jason-merlo/AP-S-2020-Radar-Board/aps_radar.kicad_pcb

## KiCad design aps_radar.kicad_pcb (2020-03-13)

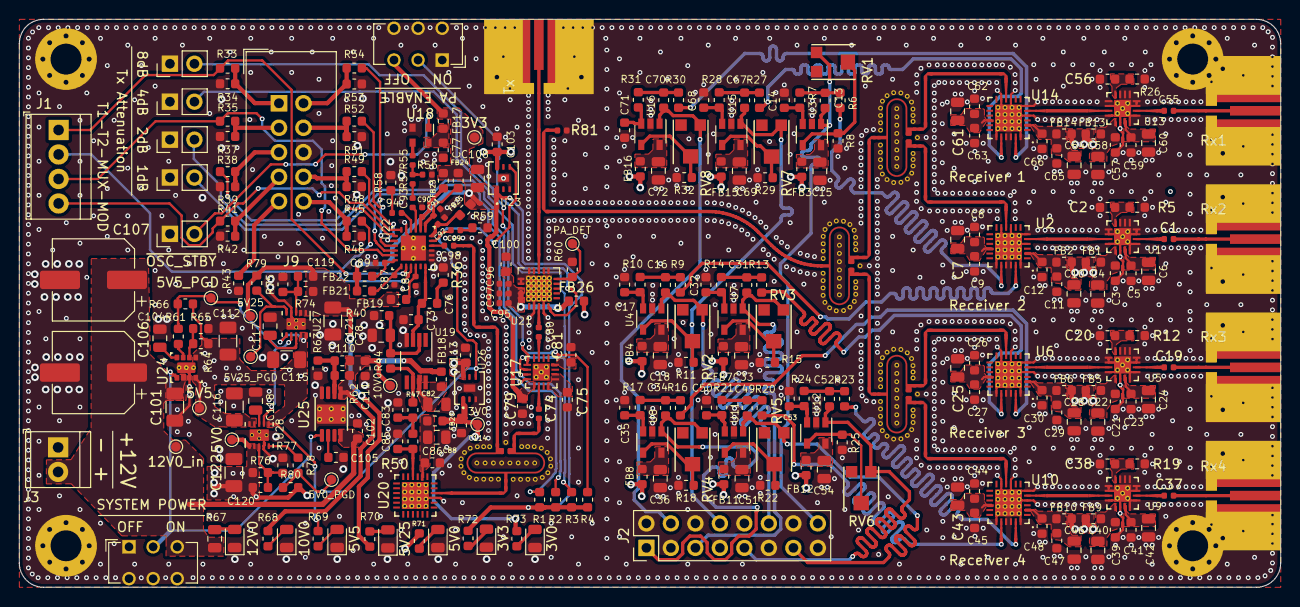
[picture p1: board aps_radar.kicad_pcb from above]

Board: 4 copper layers, 130.8 x 58.9 mm, 360 parts (0 on the bottom side), 217 nets.

Parts:
C1, C19, C37, C55: 1.2pF; C_0402_1005Metric
C2, C20, C38, C56, C86, C105, C110, C119, C120: 10nF; C_0603_1608Metric
C3, C5, C21, C23, C39, C41, C57, C59: 1000pF; C_0603_1608Metric
C4, C6, C15, C18, C22, C24, C33, C36, C40, C42, C51, C54, C58, C60, C69, C72, C78, C82, C117, C118: 0.1uF; C_0805_2012Metric
C7, C10, C25, C28, C43, C46, C61, C64, C88, C108: 4.7uF; C_0805_2012Metric
C8, C11, C26, C29, C44, C47, C62, C65: 100pF; C_0603_1608Metric
C9, C12, C13, C14, C16, C17, C27, C30, C31, C32, C34, C35, C45, C48, C49, C50, C52, C53, C63, C66, C67, C68, C70, C71, C77: 0.01uF; C_0603_1608Metric
C73: 68pF; C_0603_1608Metric
C74, C80, C93, C94, C98, C99: 10pF; C_0402_1005Metric
C75, C81: 330pF; C_0603_1608Metric
C76: 0.68nF; C_0603_1608Metric
C79, C83: 1.8nF; C_0603_1608Metric
C84, C87, C89: 100pF; C_0402_1005Metric
C85: 0.82nF; C_0603_1608Metric
C90, C91, C92, C95, C96, C97: 0.1uF; C_0402_1005Metric
C100: 10uF; C_0603_1608Metric
C101, C112, C115, C116, C121, C122: 10uF; C_1206_3216Metric
C102, C111: 2.2uF; C_0603_1608Metric
C103, C113, C114: 1uF; C_0603_1608Metric
C104: 4.3nF; C_0805_2012Metric
C106: 68uF; CP_Elec_8x11.9
C107: DNP; CP_Elec_8x11.9
D1: 12V0; D_0805_2012Metric
D2: 10V0; D_0805_2012Metric
D3: 5V5; D_0805_2012Metric
D4: 5V25; D_0805_2012Metric
D5: 5V0; D_0805_2012Metric
D6: 3V3; D_0805_2012Metric
D7: 3V0; D_0805_2012Metric
FB1, FB2, FB3, FB4, FB5, FB6, FB7, FB8, FB9, FB10, FB11, FB12, FB13, FB14, FB15, FB16, FB17, FB18, FB20, FB26: 0; L_0603_1608Metric
FB19, FB21, FB22, FB23, FB24, FB25: 120 ohm; L_0603_1608Metric
H1, H2, H3, H4: MountingHole; MountingHole_3.2mm_M3_Pad_Via
J1: TRIG_MUX_OUT; TerminalBlock_TE_282834-4_1x04_P2.54mm_Horizontal
J2: IF_OUT; PinHeader_2x08_P2.54mm_Vertical
J3: POWER_IN; TerminalBlock_TE_282834-2_1x02_P2.54mm_Horizontal
J4: Tx; SMA_Molex_Transition
J5: Rx1; SMA_Molex_Transition
J6: Rx2; SMA_Molex_Transition
J7: Rx3; SMA_Molex_Transition
J8: Rx4; SMA_Molex_Transition
J9: LMX2491_CONN; IDC-Header_2x05_P2.54mm_Vertical
JP1: 1dB; PinHeader_1x02_P2.54mm_Vertical
JP2: 2dB; PinHeader_1x02_P2.54mm_Vertical
JP3: 4dB; PinHeader_1x02_P2.54mm_Vertical
JP4: 8dB; PinHeader_1x02_P2.54mm_Vertical
JP5: ~OSC_STBY; PinHeader_1x02_P2.54mm_Vertical
R1, R2, R3, R4, R33, R34, R35, R37, R38, R39, R41, R42, R45, R46, R48, R49, R51, R52, R53, R54, R60, R63: 10k; R_0603_1608Metric
R5, R12, R19, R26: 825; R_0603_1608Metric
R6, R7, R8, R9, R10, R11, R13, R14, R15, R16, R17, R18, R20, R21, R22, R23, R24, R25, R27, R28, R29, R30, R31, R32, R68: 499; R_0603_1608Metric
R36: 1.2k; R_0603_1608Metric
R40: 1.0k; R_0603_1608Metric
R43: DNP; R_0603_1608Metric
R44: 1.24k; R_0603_1608Metric
R47: 8.2; R_0603_1608Metric
R50: 22; R_0603_1608Metric
R55, R57: 18; R_0402_1005Metric
R56: 68; R_0402_1005Metric
R58, R59: 51; R_0603_1608Metric
R61, R78: 0; R_0603_1608Metric
R62: 86.6k; R_0603_1608Metric
R64: 590k; R_0603_1608Metric
R65, R66, R79, R80: 100k; R_0603_1608Metric
R67: 649; R_0805_2012Metric
R69: 274; R_0603_1608Metric
R70: 261; R_0603_1608Metric
R71: 249; R_0603_1608Metric
R72: 165; R_0603_1608Metric
R73: 150; R_0603_1608Metric
R74, R76: 332k; R_0603_1608Metric
R75: 59.7k; R_0603_1608Metric
R77: 63.4k; R_0603_1608Metric
R81: 50; R_0402_1005Metric
RV1, RV2, RV3, RV4, RV5, RV6, RV7, RV8: 50k; Bourns_Trimpot_TC33
SW1: PA_EN; SW_CuK_JS202011AQN_DPDT_Angled
SW2: ON/OFF; SW_CuK_JS202011AQN_DPDT_Angled
TL1: coupled_line_14db
TL2, TL3, TL4, TL5: wilkinson_3dB; wilkinson_3db
TL6, TL7, TL8, TL9, TL16, TL17, TL18, TL19, TL20, TL21, TL47, TL48, TL49, TL50, TL51, TL52, TL53, TL54, TL55, TL56, TL57, TL58: mitered_bend; mitered_bend_50
TL10, TL11, TL23, TL24, TL25, TL26, TL27, TL28, TL29, TL30, TL31, TL32, TL33, TL34, TL35, TL36, TL37, TL38, TL39, TL40, TL41, TL42, TL43, TL44, TL45, TL46: ic_taper; IC_Taper_0.22_0.35
TL12, TL13, TL14, TL15, TL22: ic_taper; IC_Taper_0.25_0.35
TP1: PA_DET; TestPoint_Pad_D1.0mm
TP2: 3V3; TestPoint_Pad_D1.0mm
TP3: 12V0_in; TestPoint_Pad_D1.0mm
TP4: 10V0; TestPoint_Pad_D1.0mm
TP5: 5V5; TestPoint_Pad_D1.0mm
TP6: 5V5_PGD; TestPoint_Pad_D1.0mm
TP7: 3V0; TestPoint_Pad_D1.0mm
TP8: 5V25; TestPoint_Pad_D1.0mm
TP9: 5V25_PGD; TestPoint_Pad_D1.0mm
TP10: 5V0; TestPoint_Pad_D1.0mm
TP11: 5V0_PGD; TestPoint_Pad_D1.0mm
U1, U5, U9, U13: HMC717A; HMC-LP3
U2, U6, U10, U14: HMC951A; HMC-LP4
U3, U4, U7, U8, U11, U12, U15, U16: OPA192; SOT-23-5
U17: HMC540S; HMC-LP3
U18: ASDMB-100MHz; Oscillator_SMD_Abracon_ASDMB-4Pin_2.5x2.0mm
U19: OPA192; VSSOP-8_3.0x3.0mm_P0.65mm
U20: HMC431; HMC-LP4
U21: TQP5523; QFN4-20-TQP5523
U22: LMX2491RTWR
U23: LP5900-TL3.3; LP5900_NGF_6
U24: TPS82140; TPS82140SILR
U25: TPS7A49; TPS7A4901_DGN_8
U26: LP5900-TL3.0; LP5900_NGF_6
U27: TPS7A90; TPS7A9xDSKR
U28: TPS7A92; TPS7A9xDSKR

Connections:
+3V0: C114.1, FB20.2, R73.2, TP7.1, U26.1
+3V3: C79.1, C108.1, FB17.1, FB21.2, FB22.2, FB23.2, FB24.2, FB25.2, R1.1, R2.1, R3.1, R4.1, R72.2, SW1.3, TP2.1, U17.1, U23.1
+5V: C103.1, C113.1, C120.1, C122.1, FB1.1, FB2.1, FB3.1, FB4.1, FB5.1, FB6.1, FB7.1, FB8.1, FB9.1, FB10.1, FB11.1, FB12.1, FB13.1, FB14.1, FB15.1, FB16.1, FB26.2, R71.2, R76.1, R80.1, TP10.1, U23.6, U26.6, U28.1, U28.2
+5V25: C119.1, C121.1, FB19.2, R70.2, R74.1, R79.1, TP8.1, U27.1, U27.2
+10V: C110.1, C111.1, FB18.2, R62.1, R68.2, TP4.1, U25.1
/LMX_MOD: J1.4, R41.2, U22.12
/LMX_MUXOUT: J1.3, R35.2, U22.17
/LMX_TRIG1: J1.1, R33.2, U22.20
/LMX_TRIG2: J1.2, R45.2, U22.21
/RX1_I: C70.1, J2.4, RV8.1, U16.1
/RX1_Q: C67.1, J2.8, RV7.1, U15.1
/RX2_I: C16.1, J2.12, RV2.1, U4.1
/RX2_Q: C13.1, J2.16, RV1.1, U3.1
/RX3_I: C34.1, J2.1, RV4.1, U8.1
/RX3_Q: C31.1, J2.5, RV3.1, U7.1
/RX4_I: C52.1, J2.9, RV6.1, U12.1
/RX4_Q: C49.1, J2.13, RV5.1, U11.1
/power/5V0_PGD: R78.1, R80.2, TP11.1, U23.4, U26.4
/power/5V5_OUT: C112.1, C115.1, C116.1, R64.1, R66.1, R69.2, TP5.1, U24.4, U24.5, U27.6, U27.9, U27.10, U28.6, U28.9, U28.10
/power/5V5_PGD: R61.1, R66.2, TP6.1, U27.7, U28.7
/power/5V25_PGD: R79.2, TP9.1, U27.5
/power/+12V0_IN_CONN: C101.1, C102.1, C106.1, C107.1, J3.2, R67.2, SW2.3, TP3.1, U24.2, U25.8
/power/POWER_SW: SW2.2, U24.1, U25.5
/receiver_1/ANT_IN: C55.2, J5.1
/receiver_1/IF1_RAW: R30.2, TL45.2
/receiver_1/IF2_RAW: R27.2, TL46.2
/receiver_1/LNA_OUT: TL32.2, TL36.2
/receiver_2/ANT_IN: C1.2, J6.1
/receiver_2/IF1_RAW: R9.2, TL24.2
/receiver_2/IF2_RAW: R6.2, TL37.2
/receiver_2/LNA_OUT: TL29.2, TL33.2
/receiver_3/ANT_IN: C19.2, J7.1
/receiver_3/IF1_RAW: R16.2, TL39.2
/receiver_3/IF2_RAW: R13.2, TL40.2
/receiver_3/LNA_OUT: TL30.2, TL34.2
/receiver_4/ANT_IN: C37.2, J8.1
/receiver_4/IF1_RAW: R23.2, TL42.2
/receiver_4/IF2_RAW: R20.2, TL43.2
/receiver_4/LNA_OUT: TL31.2, TL35.2
/transmitter/ATTEN_OUT: C80.2, TL14.2
/transmitter/LMX_CE: R38.2, U22.13
/transmitter/LMX_CLK: R49.2, U22.14
/transmitter/LMX_CPOUT: C73.1, C76.1, TL22.2, U19.3
/transmitter/LMX_DATA: R52.2, U22.15
/transmitter/LMX_FIN: C98.1, TL19.1
/transmitter/LMX_LE: R54.2, U22.16
/transmitter/LMX_VCP: C84.1, FB19.1, U22.22
/transmitter/LO_1: TL50.1, TL55.2
/transmitter/LO_2: TL47.1, TL57.1
/transmitter/LO_3: TL48.1, TL56.2
/transmitter/LO_4: TL49.1, TL58.1
/transmitter/PA_OUT: TL1.1, TL15.2
/transmitter/REF_OUT: R55.2, U18.3
/transmitter/TX_OUT: J4.1, TL1.2
/transmitter/VCO_OUT: C74.1, TL21.1
/~ATTEN_1DB: JP1.2, R1.2, U17.16
/~ATTEN_2DB: JP2.2, R2.2, U17.15
/~ATTEN_4DB: JP3.2, R3.2, U17.14
/~ATTEN_8DB: JP4.2, R4.2, U17.13
GND: C2.2, C3.2, C4.2, C5.2, C6.2, C7.2, C8.1, C9.1, C10.2, C11.1, C12.1, C14.2, C15.2, C17.2, C18.2, C20.2, C21.2, C22.2, C23.2, C24.2, C25.2, C26.1, C27.1, C28.2, C29.1, C30.1, C32.2, C33.2, C35.2, C36.2, C38.2, C39.2, C40.2, C41.2, C42.2, C43.2, C44.1, C45.1, C46.2, C47.1, C48.1, C50.2, C51.2, C53.2, C54.2, C56.2, C57.2, C58.2, C59.2, C60.2, C61.2, C62.1, C63.1, C64.2, C65.1, C66.1, C68.2, C69.2, C71.2, C72.2, C73.2, C75.1, C77.2, C78.2, C79.2, C81.2, C82.2, C83.2, C84.2, C85.2, C86.2, C87.2, C88.2, C89.2, C90.2, C91.2, C92.2, C95.2, C96.2, C97.2, C100.2, C101.2, C102.2, C103.2, C104.2, C105.2, C106.2, C107.2, C108.2, C111.2, C112.2, C113.2, C114.2, C115.2, C116.2, C117.2, C118.2, C121.2, C122.2, D1.1, D2.1, D3.1, D4.1, D5.1, D6.1, D7.1, H1.1, H2.1, H3.1, H4.1, J2.2, J2.3, J2.6, J2.7, J2.10, J2.11, J2.14, J2.15, J3.1, J4.2, J5.2, J6.2, J7.2, J8.2, J9.6, JP1.1, JP2.1, JP3.1, JP4.1, JP5.1, R5.1, R8.2, R11.2, R12.1, R15.2, R18.2, R19.1, R22.2, R25.2, R26.1, R29.2, R32.2, R34.1, R36.2, R37.1, R39.1, R40.2, R42.1, R43.1, R46.1, R48.1, R51.1, R53.1, R56.2, R58.1, R59.1, R60.2, R63.2, R65.2, R75.2, R77.2, R81.2, SW1.1, SW1.4, SW1.5, SW1.6, SW2.1, SW2.4, SW2.5, SW2.6, TL2.5, TL3.5, TL4.5, TL5.5, U1.1, U1.3, U1.4, U1.5, U1.6, U1.7, U1.9, U1.10, U1.12, U1.14, U1.16, U1.17, U2.4, U2.6, U2.9, U2.11, U2.19, U2.21, U2.22, U2.24, U2.25, U3.2, U4.2, U5.1, U5.3, U5.4, U5.5, U5.6, U5.7, U5.9, U5.10, U5.12, U5.14, U5.16, U5.17, U6.4, U6.6, U6.9, U6.11, U6.19, U6.21, U6.22, U6.24, U6.25, U7.2, U8.2, U9.1, U9.3, U9.4, U9.5, U9.6, U9.7, U9.9, U9.10, U9.12, U9.14, U9.16, U9.17, U10.4, U10.6, U10.9, U10.11, U10.19, U10.21, U10.22, U10.24, U10.25, U11.2, U12.2, U13.1, U13.3, U13.4, U13.5, U13.6, U13.7, U13.9, U13.10, U13.12, U13.14, U13.16, U13.17, U14.4, U14.6, U14.9, U14.11, U14.19, U14.21, U14.22, U14.24, U14.25, U15.2, U16.2, U17.17, U18.2, U19.4, U20.15, U20.25, U21.2, U21.4, U21.11, U21.12, U21.14, U21.15, U21.16, U21.17, U21.21, U22.1, U22.2, U22.3, U22.11, U22.25, U23.3, U23.7, U24.3, U24.9, U25.4, U25.9, U26.3, U26.7, U27.4, U27.11, U28.4, U28.11
unnamed: C1.1, TL25.2
unnamed: C2.1, R5.2, U1.8
unnamed: C3.1, C4.1, C5.1, C6.1, FB1.2, U1.13, U1.15
unnamed: C7.1, C8.2, C9.2, C10.1, C11.2, C12.2, FB2.2, U2.2, U2.16
unnamed: C13.2, R6.1, R7.2
unnamed: C14.1, R7.1, U3.3
unnamed: C15.1, FB3.2, U3.5
unnamed: C16.2, R9.1, R10.2
unnamed: C17.1, R10.1, U4.3
unnamed: C18.1, FB4.2, U4.5
unnamed: C19.1, TL26.2
unnamed: C20.1, R12.2, U5.8
unnamed: C21.1, C22.1, C23.1, C24.1, FB5.2, U5.13, U5.15
unnamed: C25.1, C26.2, C27.2, C28.1, C29.2, C30.2, FB6.2, U6.2, U6.16
unnamed: C31.2, R13.1, R14.2
unnamed: C32.1, R14.1, U7.3
unnamed: C33.1, FB7.2, U7.5
unnamed: C34.2, R16.1, R17.2
unnamed: C35.1, R17.1, U8.3
unnamed: C36.1, FB8.2, U8.5
unnamed: C37.1, TL27.2
unnamed: C38.1, R19.2, U9.8
unnamed: C39.1, C40.1, C41.1, C42.1, FB9.2, U9.13, U9.15
unnamed: C43.1, C44.2, C45.2, C46.1, C47.2, C48.2, FB10.2, U10.2, U10.16
unnamed: C49.2, R20.1, R21.2
unnamed: C50.1, R21.1, U11.3
unnamed: C51.1, FB11.2, U11.5
unnamed: C52.2, R23.1, R24.2
unnamed: C53.1, R24.1, U12.3
unnamed: C54.1, FB12.2, U12.5
unnamed: C55.1, TL28.2
unnamed: C56.1, R26.2, U13.8
unnamed: C57.1, C58.1, C59.1, C60.1, FB13.2, U13.13, U13.15
unnamed: C61.1, C62.2, C63.2, C64.1, C65.2, C66.2, FB14.2, U14.2, U14.16
unnamed: C67.2, R27.1, R28.2
unnamed: C68.1, R28.1, U15.3
unnamed: C69.1, FB15.2, U15.5
unnamed: C70.2, R30.1, R31.2
unnamed: C71.1, R31.1, U16.3
unnamed: C72.1, FB16.2, U16.5
unnamed: C74.2, TL10.2
unnamed: C75.2, U17.4, U17.5, U17.6
unnamed: C76.2, R36.1
unnamed: C77.1, FB17.2, U18.4
unnamed: C78.1, R40.1, R44.2, U19.2
unnamed: C80.1, TL11.2
unnamed: C81.1, U17.8
unnamed: C82.1, FB18.1, U19.7
unnamed: C83.1, R47.1, R50.2
unnamed: C85.1, R50.1, TL12.2
unnamed: C86.1, C88.1, FB20.1, U20.20
unnamed: C93.1, U22.9
unnamed: C93.2, R57.1
unnamed: C94.1, U22.10
unnamed: C94.2, R58.2
unnamed: C98.2, U22.4
unnamed: C99.1, R59.2
unnamed: C99.2, U22.5
unnamed: C95.1, C96.1, C97.1, C100.1, FB26.1, U21.18, U21.19, U21.20
unnamed: C104.1, U24.8
unnamed: C105.1, U25.6
unnamed: C110.2, R62.2, R63.1, U25.2
unnamed: C117.1, U27.8
unnamed: C118.1, U28.8
unnamed: C119.2, R74.2, R75.1, U27.3
unnamed: C120.2, R76.2, R77.1, U28.3
unnamed: D1.2, R67.1
unnamed: D2.2, R68.1
unnamed: D3.2, R69.1
unnamed: D4.2, R70.1
unnamed: D5.2, R71.1
unnamed: D6.2, R72.1
unnamed: D7.2, R73.1
unnamed: J9.1, R33.1, R34.2
unnamed: J9.2, R53.2, R54.1
unnamed: J9.3, R35.1, R37.2
unnamed: J9.4, R51.2, R52.1
unnamed: J9.5, R38.1, R39.2
unnamed: J9.7, R41.1, R42.2
unnamed: J9.8, R48.2, R49.1
unnamed: J9.9, R43.2
unnamed: J9.10, R45.1, R46.2
unnamed: JP5.2, U18.1
unnamed: R8.1, RV1.2, U3.4
unnamed: R11.1, RV2.2, U4.4
unnamed: R15.1, RV3.2, U7.4
unnamed: R18.1, RV4.2, U8.4
unnamed: R22.1, RV5.2, U11.4
unnamed: R25.1, RV6.2, U12.4
unnamed: R29.1, RV7.2, U15.4
unnamed: R32.1, RV8.2, U16.4
unnamed: R44.1, R47.2, U19.6
unnamed: R55.1, R56.1, R57.2
unnamed: R60.1, TP1.1, U21.10
unnamed: R61.2, U24.7
unnamed: R64.2, R65.1, U24.6
unnamed: R78.2, U28.5
unnamed: R81.1, TL1.3
unnamed: SW1.2, U21.5
unnamed: TL1.4, TL2.1
unnamed: TL2.2, TL8.2
unnamed: TL2.3, TL6.1
unnamed: TL3.1, TL7.2
unnamed: TL3.2, TL53.2
unnamed: TL3.3, TL51.1
unnamed: TL4.1, TL9.1
unnamed: TL4.2, TL54.2
unnamed: TL4.3, TL52.1
unnamed: TL6.2, TL9.2
unnamed: TL7.1, TL8.1
unnamed: TL10.1, U17.2
unnamed: TL11.1, U17.11
unnamed: TL12.1, U20.22
unnamed: TL13.1, U20.16
unnamed: TL13.2, TL16.2
unnamed: TL14.1, U21.3
unnamed: TL15.1, U21.13
unnamed: TL5.1, TL16.1
unnamed: TL17.1, TL18.1
unnamed: TL5.2, TL17.2
unnamed: TL18.2, TL19.2
unnamed: TL5.3, TL20.1
unnamed: TL20.2, TL21.2
unnamed: TL22.1, U22.24
unnamed: TL23.1, U2.10
unnamed: TL23.2, TL47.2
unnamed: TL24.1, U2.23
unnamed: TL25.1, U1.2
unnamed: TL26.1, U5.2
unnamed: TL27.1, U9.2
unnamed: TL28.1, U13.2
unnamed: TL29.1, U1.11
unnamed: TL30.1, U5.11
unnamed: TL31.1, U9.11
unnamed: TL32.1, U13.11
unnamed: TL33.1, U2.5
unnamed: TL34.1, U6.5
unnamed: TL35.1, U10.5
unnamed: TL36.1, U14.5
unnamed: TL37.1, U2.20
unnamed: TL38.1, U6.10
unnamed: TL38.2, TL48.2
unnamed: TL39.1, U6.23
unnamed: TL40.1, U6.20
unnamed: TL41.1, U10.10
unnamed: TL41.2, TL49.2
unnamed: TL42.1, U10.23
unnamed: TL43.1, U10.20
unnamed: TL44.1, U14.10
unnamed: TL44.2, TL50.2
unnamed: TL45.1, U14.23
unnamed: TL46.1, U14.20
unnamed: TL51.2, TL57.2
unnamed: TL52.2, TL58.2
unnamed: TL53.1, TL55.1
unnamed: TL54.1, TL56.1
VCC: C87.1, C89.1, C90.1, C91.1, C92.1, FB21.1, FB22.1, FB23.1, FB24.1, FB25.1, U22.6, U22.7, U22.8, U22.18, U22.19
