jason-merlo/AP-S-2020-Radar-Board/(commit log)

2020-02-06 Added substrate characteriztion board
    [aps_radar.kicad_pcb, aps_radar.sch]
2020-02-06 I added footprint and schematic for hmc951a
2020-02-06 added substrate characterization board
    [aps_radar.kicad_pcb, aps_radar.sch]
2020-02-06 Added radar project
    [aps_radar.kicad_pcb, aps_radar.sch, receiver.sch, transmitter.sch]
2020-02-07 Updated footprints, added LNA
    [aps_radar.sch]
2020-02-07 added HCP_16_3 footprint
2020-02-07 added footprint and schematic for bpf
    [aps_radar.sch, receiver.sch, transmitter.sch]
2020-02-07 Added tracking for footprint library
2020-02-07 added more
    [receiver.sch]
2020-02-07 Removed duplicate footprint, cleaned up footprints
2020-02-11 Began transmitter layout
    [aps_radar.sch, receiver.sch, transmitter.sch]
2020-02-21 Added transmitter components
    [transmitter.sch]
2020-02-26 updated SMA footprint, added splitter symbol
2020-02-26 Added footprints for couplers
2020-02-26 Updated sma footprint
    [aps_radar.kicad_pcb]
2020-02-26 Renamed substrate characterization board to avoid confusion
    [substrate_characterization.kicad_pcb, substrate_characterization.sch]
2020-03-02 Finished schematic for transmitter
    [aps_radar.sch]
2020-03-02 Added transmitter.sch
    [transmitter.sch]
2020-03-02 Integrated transmitter and receiver. Need to add ferrite beads and power supply module.
    [aps_radar.sch, if_filter.sch, receiver.sch, transmitter.sch]
2020-03-02 Moved substrate characterization board to its own repo.
    [substrate_characterization.kicad_pcb, substrate_characterization.sch]
2020-03-02 Updated gitignore and folder structure
    [aps_radar.kicad_pcb, aps_radar.sch, if_filter.sch, receiver.sch, transmitter.sch]
2020-03-04 Finished power schematic and main page
    [aps_radar.sch, if_filter.sch, power.sch, receiver.sch, transmitter.sch]
2020-03-05 Addressed all TODOs
    [aps_radar.sch, if_filter.sch, power.sch, receiver.sch, transmitter.sch]
2020-03-06 Started footprint association
    [aps_radar.sch, if_filter.sch, power.sch, receiver.sch, transmitter.sch]
2020-03-07 Assigned components to each part
    [aps_radar.sch, if_filter.sch, power.sch, receiver.sch, transmitter.sch]
2020-03-07 Updated potentiometer footprint, started layout
    [aps_radar.kicad_pcb, if_filter.sch, receiver.sch]
2020-03-09 Layout updates
    [aps_radar.kicad_pcb, aps_radar.sch, if_filter.sch, receiver.sch, transmitter.sch]
2020-03-10 Finished placing transmitter and power
    [aps_radar.kicad_pcb, if_filter.sch, power.sch, receiver.sch, transmitter.sch]
2020-03-10 Began receiver layout
    [aps_radar.kicad_pcb, aps_radar.sch, power.sch, receiver.sch, transmitter.sch]
2020-03-11 Finished placing parts
    [aps_radar.kicad_pcb, aps_radar.sch, if_filter.sch, power.sch, receiver.sch, transmitter.sch]
2020-03-12 Finished layout
    [aps_radar.kicad_pcb, aps_radar.sch, if_filter.sch, receiver.sch, transmitter.sch]
2020-03-13 Added SMA model
    [aps_radar.kicad_pcb]
