jason-merlo/AP-S-2020-Radar-Board/(notices)

Notices in the files:
parts and their libraries:
Copyright 2016 Accelerated Designs. All rights reserved.
